phreaknik/MSP432-RGB-LED-Panel-Controller/(threads)

Thread 12 (2015-12-04):

[DOCUMENTATION] - Update firmware license

phreaknik, 2015-12-04:
Perhaps migrate to MIT license, but make sure there are no copyright issues with TI software

phreaknik, 2015-12-04:
Looks like I might have to use TI's license. Read the license in one of the source files, and it says this.

phreaknik, 2015-12-04:
Looks like the only two files that have the TI license are:
 - msp432_startup_ccs.c
 - msp432p401r.cmd
 - (Verify there are no other TI licensed files)

If this is the case, I may not have to use the TI license if I can get the project to work without these files.

msp432_startup_ccs.c - This file holds the interrupt vector table. If I create my own functions within DisplayDriverLib to register interrupts without using this file, then I may not need this file at all.

msp432p401r.cmd - This file may be unnecessary altogether. It looks like it gets auto-generated by CCS, and therefore I dont need to include it with the source code

Thread 5 (2015-12-04):

Hardware - Move voltage regulator away from DC jack.

phreaknik, 2015-12-04:
The clearance between the voltage regulator and the DC jack is too close for comfort when a heatsink is mounted on the regulator.
