phreaknik/MSP432-RGB-LED-Panel-Controller/Hardware/board.pdf

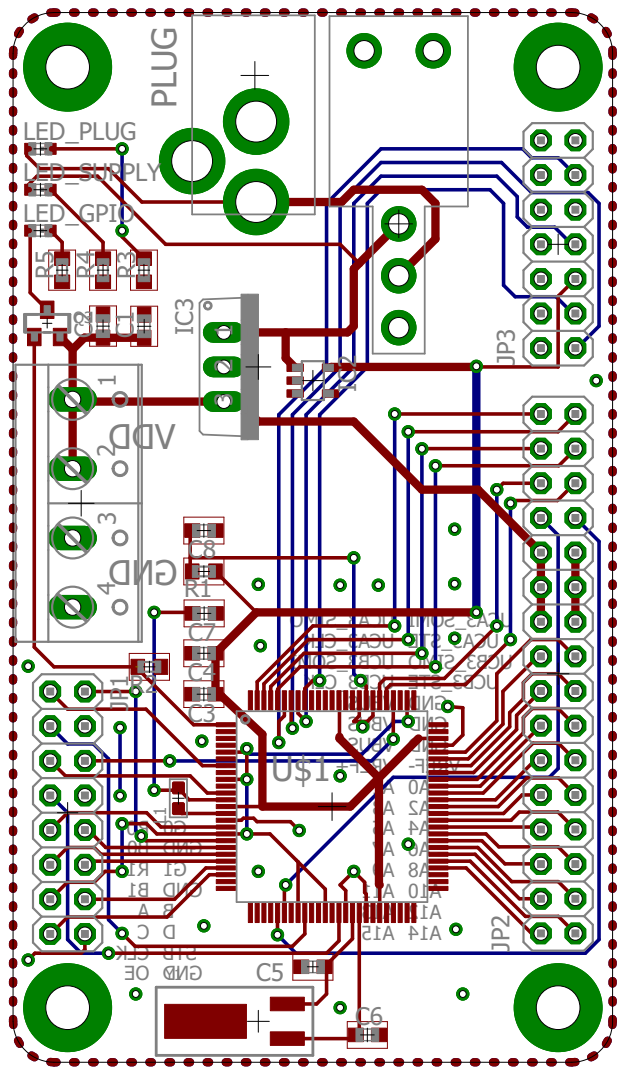
[picture p1: page 1]
