phreaknik/MSP432-RGB-LED-Panel-Controller/Hardware/schematic.pdf

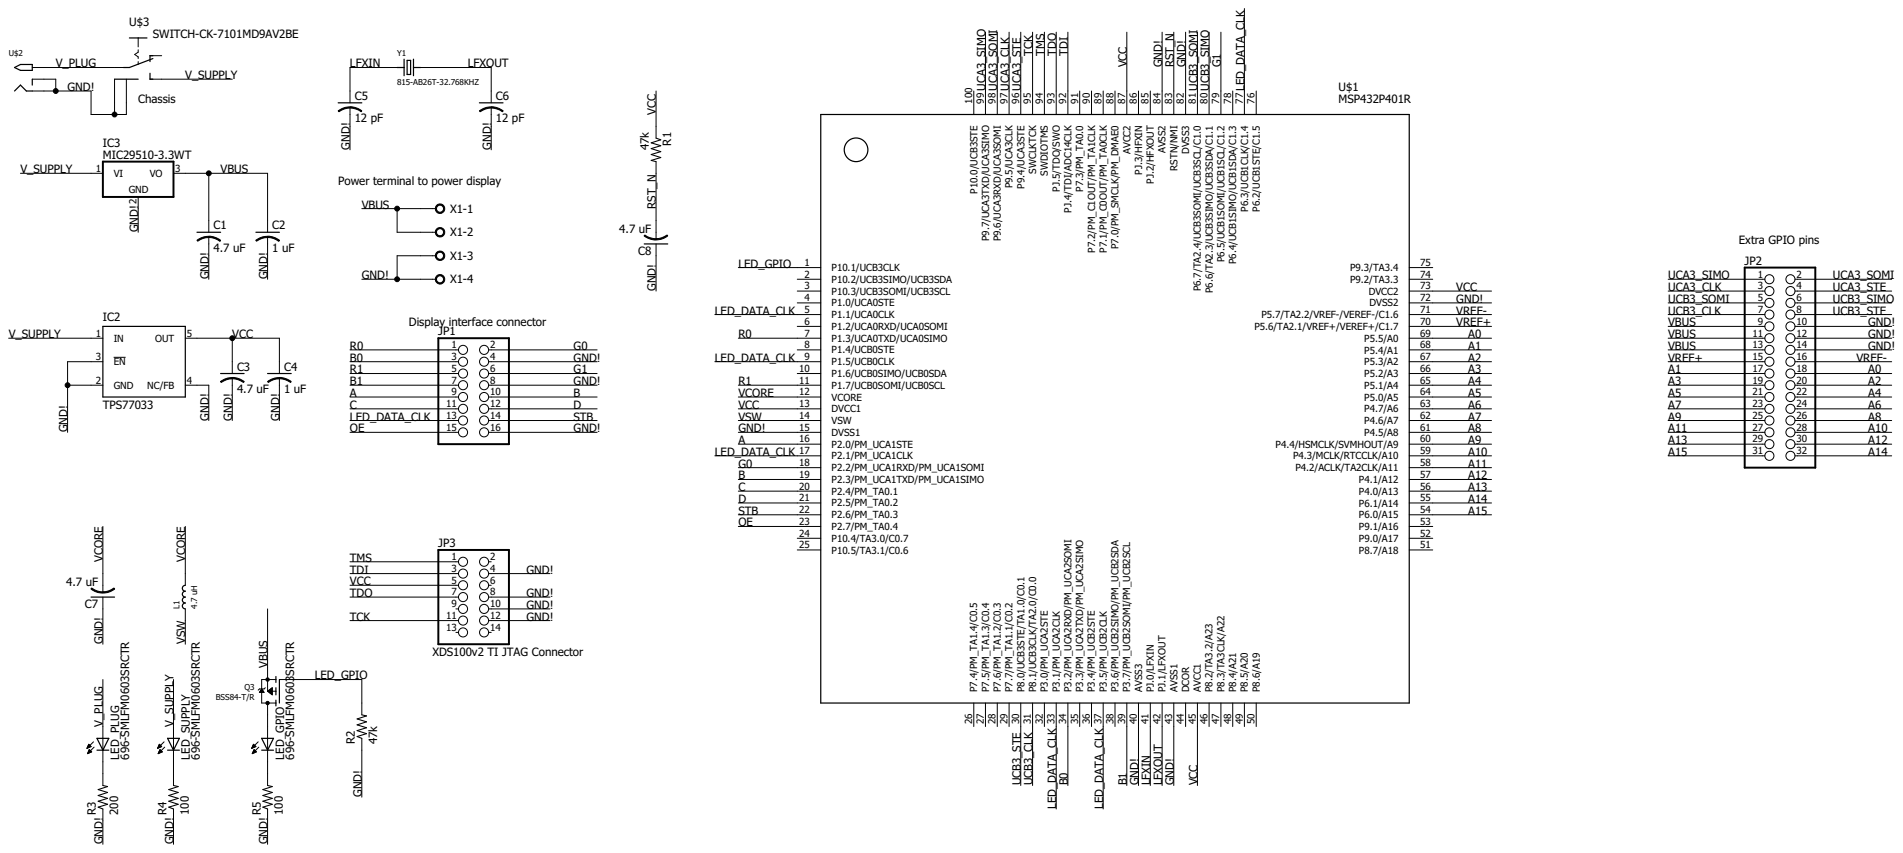
[picture p2: page 1]
