phreaknik/MSP432-RGB-LED-Panel-Controller/Hardware/EagleCAD/RGBDisplayDriver.brd

## EAGLE design Hardware/EagleCAD/RGBDisplayDriver.brd (2015-12-03)

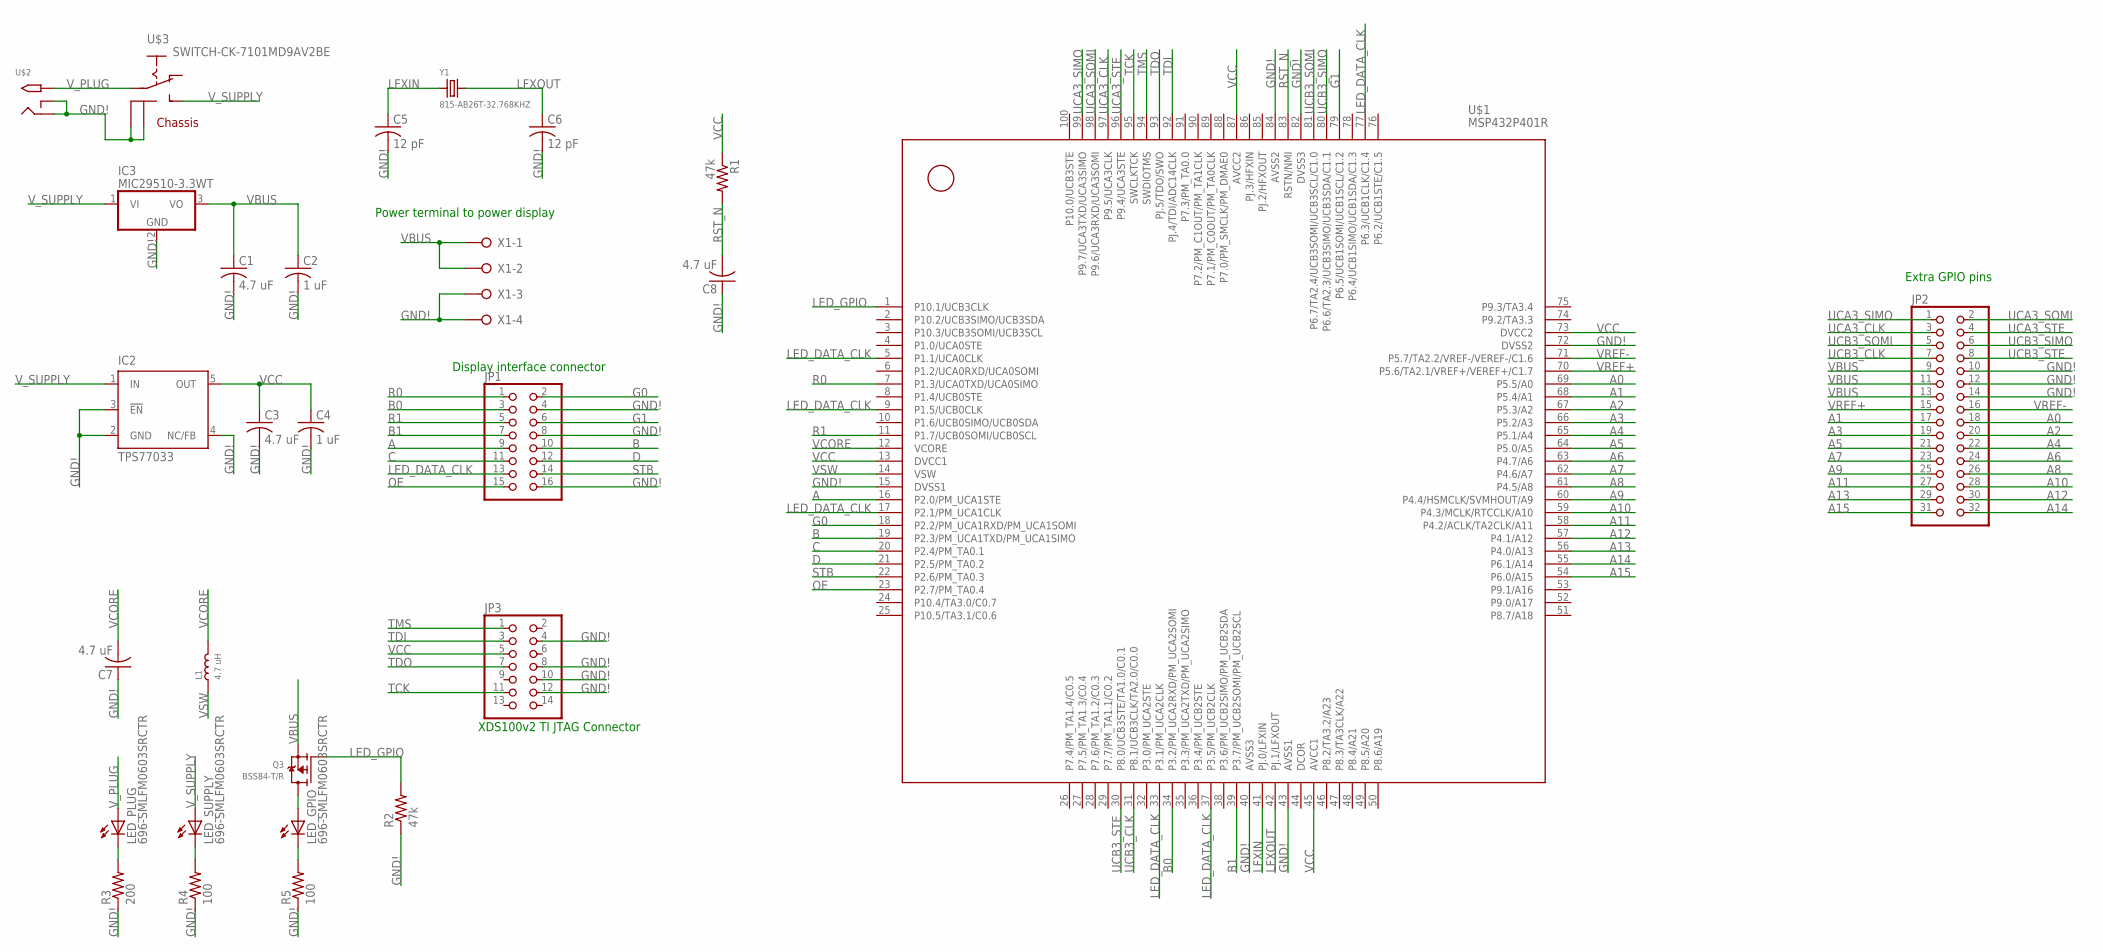
[picture p3: schematic RGBDisplayDriver.sch]

Parts:
C1, C3, C7, C8: 4.7 uF; C0603
C2, C4: 1 uF; C0603
C5, C6: 12 pF; C0603
IC2: TPS77033; SOT23-DBV
IC3: MIC29510-3.3WT; TO220V
JP1: PINHD-2X8; 2X08
JP2: PINHD-2X16; 2X16
JP3: PINHD-2X7; 2X07
L1: 4.7 uH; L0603
LED_GPIO: 696-SMLFM0603SRCTR; CHIPLED_0603
LED_PLUG: 696-SMLFM0603SRCTR; CHIPLED_0603
LED_SUPPLY: 696-SMLFM0603SRCTR; CHIPLED_0603
Q3: BSS84-T/R; SOT23-WIDE
R1, R2: 47k; R0603
R3: 200; R0603
R4, R5: 100; R0603
U$1: MSP432P401R; LQFP100
U$2: 2.1MMJACKTHM; PJ-102A
U$3: SWITCH-CK-7101MD9AV2BE
X1: W237-04P; W237-4P
Y1: 815-AB26T-32.768KHZ; CRYSTAL_CYL_2X6MM_SMT

Connections:
A: JP1.9, U$1.16 (P2.0/PM_UCA1STE)
A0: JP2.18, U$1.69 (P5.5/A0)
A1: JP2.17, U$1.68 (P5.4/A1)
A2: JP2.20, U$1.67 (P5.3/A2)
A3: JP2.19, U$1.66 (P5.2/A3)
A4: JP2.22, U$1.65 (P5.1/A4)
A5: JP2.21, U$1.64 (P5.0/A5)
A6: JP2.24, U$1.63 (P4.7/A6)
A7: JP2.23, U$1.62 (P4.6/A7)
A8: JP2.26, U$1.61 (P4.5/A8)
A9: JP2.25, U$1.60 (P4.4/HSMCLK/SVMHOUT/A9)
A10: JP2.28, U$1.59 (P4.3/MCLK/RTCCLK/A10)
A11: JP2.27, U$1.58 (P4.2/ACLK/TA2CLK/A11)
A12: JP2.30, U$1.57 (P4.1/A12)
A13: JP2.29, U$1.56 (P4.0/A13)
A14: JP2.32, U$1.55 (P6.1/A14)
A15: JP2.31, U$1.54 (P6.0/A15)
B: JP1.10, U$1.19 (P2.3/PM_UCA1TXD/PM_UCA1SIMO)
B0: JP1.3, U$1.34 (P3.2/PM_UCA2RXD/PM_UCA2SOMI)
B1: JP1.7, U$1.39 (P3.7/PM_UCB2SOMI/PM_UCB2SCL)
C: JP1.11, U$1.20 (P2.4/PM_TA0.1)
D: JP1.12, U$1.21 (P2.5/PM_TA0.2)
G0: JP1.2, U$1.18 (P2.2/PM_UCA1RXD/PM_UCA1SOMI)
G1: JP1.6, U$1.79 (P6.5/UCB1SOMI/UCB1SCL/C1.2)
GND!: C1.2, C2.2, C3.2, C4.2, C5.2, C6.2, C7.1, C8.1, IC2.2 (GND), IC2.3 (!EN), IC2.4 (NC/FB), IC3.2 (GND), JP1.4, JP1.8, JP1.16, JP2.10, JP2.12, JP2.14, JP3.4, JP3.8, JP3.10, JP3.12, R2.1, R3.1, R4.1, R5.1, U$1.15 (DVSS1), U$1.40 (AVSS3), U$1.43 (AVSS1), U$1.72 (DVSS2), U$1.82 (DVSS3), U$1.84 (AVSS2), U$2.RING, U$2.RING_SW, U$3.P$4, U$3.P$5, X1.3, X1.4
LED_DATA_CLK: JP1.13, U$1.5 (P1.1/UCA0CLK), U$1.9 (P1.5/UCB0CLK), U$1.17 (P2.1/PM_UCA1CLK), U$1.33 (P3.1/PM_UCA2CLK), U$1.37 (P3.5/PM_UCB2CLK), U$1.77 (P6.3/UCB1CLK/C1.4)
LED_GPIO: Q3.1 (G), R2.2, U$1.1 (P10.1/UCB3CLK)
LFXIN: C5.1, U$1.41 (PJ.0/LFXIN), Y1.1
LFXOUT: C6.1, U$1.42 (PJ.1/LFXOUT), Y1.2
unnamed: LED_GPIO.A, Q3.3 (D)
unnamed: LED_PLUG.C, R3.2
unnamed: LED_SUPPLY.C, R4.2
unnamed: LED_GPIO.C, R5.2
OE: JP1.15, U$1.23 (P2.7/PM_TA0.4)
R0: JP1.1, U$1.7 (P1.3/UCA0TXD/UCA0SIMO)
R1: JP1.5, U$1.11 (P1.7/UCB0SOMI/UCB0SCL)
RST_N: C8.2, R1.2, U$1.83 (RSTN/NMI)
STB: JP1.14, U$1.22 (P2.6/PM_TA0.3)
TCK: JP3.11, U$1.95 (SWCLKTCK)
TDI: JP3.3, U$1.92 (PJ.4/TDI/ADC14CLK)
TDO: JP3.7, U$1.93 (PJ.5/TDO/SWO)
TMS: JP3.1, U$1.94 (SWDIOTMS)
UCA3_CLK: JP2.3, U$1.97 (P9.5/UCA3CLK)
UCA3_SIMO: JP2.1, U$1.99 (P9.7/UCA3TXD/UCA3SIMO)
UCA3_SOMI: JP2.2, U$1.98 (P9.6/UCA3RXD/UCA3SOMI)
UCA3_STE: JP2.4, U$1.96 (P9.4/UCA3STE)
UCB3_CLK: JP2.7, U$1.31 (P8.1/UCB3CLK/TA2.0/C0.0)
UCB3_SIMO: JP2.6, U$1.80 (P6.6/TA2.3/UCB3SIMO/UCB3SDA/C1.1)
UCB3_SOMI: JP2.5, U$1.81 (P6.7/TA2.4/UCB3SOMI/UCB3SCL/C1.0)
UCB3_STE: JP2.8, U$1.30 (P8.0/UCB3STE/TA1.0/C0.1)
VBUS: C1.1, C2.1, IC3.3 (VO), JP2.9, JP2.11, JP2.13, Q3.2 (S), X1.1, X1.2
VCC: C3.1, C4.1, IC2.5 (OUT), JP3.5, R1.1, U$1.13 (DVCC1), U$1.45 (AVCC1), U$1.73 (DVCC2), U$1.87 (AVCC2)
VCORE: C7.2, L1.2, U$1.12 (VCORE)
VREF+: JP2.15, U$1.70 (P5.6/TA2.1/VREF+/VEREF+/C1.7)
VREF-: JP2.16, U$1.71 (P5.7/TA2.2/VREF-/VEREF-/C1.6)
VSW: L1.1, U$1.14 (VSW)
V_PLUG: LED_PLUG.A, U$2.TIP, U$3.P$2
V_SUPPLY: IC2.1 (IN), IC3.1 (VI), LED_SUPPLY.A, U$3.P$1

Notes on the sheet:
Power terminal to power display
Display interface connector
Extra GPIO pins
XDS100v2 TI JTAG Connector

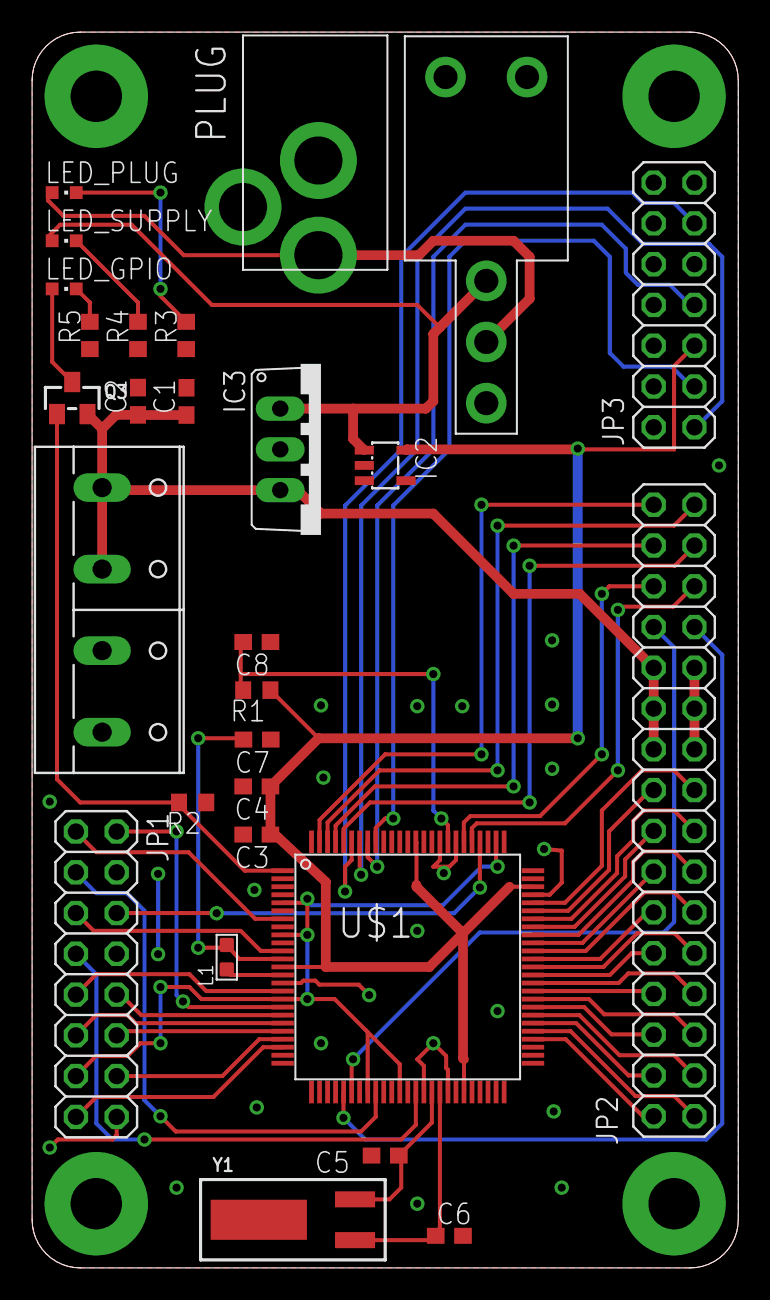
[picture p4: board RGBDisplayDriver.brd from above]

Board: 2 copper layers, 44.0 x 77.0 mm, 28 parts (0 on the bottom side), 58 nets.
