phreaknik/MSP432-RGB-LED-Panel-Controller/Firmware/CCSv6_workspace/DisplayDriver/RGB-LED-Panel-Library/char_map.h

/*
 * char_map.h
 *
 *  Created on: Dec 3, 2015
 *      Author: John
 */

#ifndef CHAR_MAP_H_
#define CHAR_MAP_H_


// Define ASCII character map
const uint32_t charMap[128][7] = {
								{	// Blank
									0b00000,
									0b00000,
									0b00000,
									0b00000,
									0b00000,
									0b00000
								},

								{	// Blank
									0b00000,
									0b00000,
									0b00000,
									0b00000,
									0b00000,
									0b00000
								},

								{	// Blank
									0b00000,
									0b00000,
									0b00000,
									0b00000,
									0b00000,
									0b00000
								},

								{	// Blank
									0b00000,
									0b00000,
									0b00000,
									0b00000,
									0b00000,
									0b00000
								},

								{	// Blank
									0b00000,
									0b00000,
									0b00000,
									0b00000,
									0b00000,
									0b00000
								},

								{	// Blank
									0b00000,
									0b00000,
									0b00000,
									0b00000,
									0b00000,
									0b00000
								},

								{	// Blank
									0b00000,
									0b00000,
									0b00000,
									0b00000,
									0b00000,
									0b00000
								},

								{	// Blank
									0b00000,
									0b00000,
									0b00000,
									0b00000,
									0b00000,
									0b00000
								},

								{	// Blank
									0b00000,
									0b00000,
									0b00000,
									0b00000,
									0b00000,
									0b00000
								},

								{	// Blank
									0b00000,
									0b00000,
									0b00000,
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
									0b00010,
									0b00100,
									0b00100,
									0b01000
								},

								{	// '~'
									0b00000,
									0b00000,
									0b01000,
									0b10101,
									0b00010,
									0b00000,
									0b00000
								}
								};

#endif /* RGB_LED_PANEL_LIBRARY_CHAR_MAP_H_ */
