phreaknik/MSP432-RGB-LED-Panel-Controller/Firmware/CCSv6_workspace/DisplayDriver/msp432_startup_ccs.c

//*****************************************************************************
//
// Copyright (C) 2012 - 2014 Texas Instruments Incorporated - http://www.ti.com/
//
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
//  Redistributions of source code must retain the above copyright 
//  notice, this list of conditions and the following disclaimer.
//
//  Redistributions in binary form must reproduce the above copyright
//  notice, this list of conditions and the following disclaimer in the 
//  documentation and/or other materials provided with the   
//  distribution.
//
//  Neither the name of Texas Instruments Incorporated nor the names of
//  its contributors may be used to endorse or promote products derived
//  from this software without specific prior written permission.
//
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
// MSP432 Family Interrupt Vector Table for CGT
//
//****************************************************************************

/* Forward declaration of the default fault handlers. */
static void resetISR(void);
static void nmiISR(void);
static void faultISR(void);
static void intDefaultHandler(void);


/* External declaration for the reset handler that is to be called when the */
/* processor is started                                                     */
extern void _c_int00(void);


/* Linker variable that marks the top of the stack. */
extern unsigned long __STACK_END;
/* External declarations for the interrupt handlers used by the application. */
extern void DISP__eUSCIA0ISR(void);
extern void DISP__oneShotFlashTimerISR(void);
extern void DISP__frameTimerISR(void);

/* To be added by user */


/* Intrrupt vector table.  Note that the proper constructs must be placed on this to  */
/* ensure that it ends up at physical address 0x0000.0000 or at the start of          */
/* the program if located at a start address other than 0.                            */
#pragma DATA_SECTION(interruptVectors, ".intvecs")
void (* const interruptVectors[])(void) =
{
    (void (*)(void))((unsigned long)&__STACK_END),
                                            /* The initial stack pointer */
    resetISR,                               /* The reset handler         */
    nmiISR,                                 /* The NMI handler           */
    faultISR,                               /* The hard fault handler    */
    intDefaultHandler,                      /* The MPU fault handler     */
    intDefaultHandler,                      /* The bus fault handler     */
    intDefaultHandler,                      /* The usage fault handler   */
    0,                                      /* Reserved                  */
    0,                                      /* Reserved                  */
    0,                                      /* Reserved                  */
    0,                                      /* Reserved                  */
    intDefaultHandler,                      /* SVCall handler            */
    intDefaultHandler,                      /* Debug monitor handler     */
    0,                                      /* Reserved                  */
    intDefaultHandler,                      /* The PendSV handler        */
    intDefaultHandler,                      /* The SysTick handler       */
    intDefaultHandler,                      /* PSS ISR                   */
    intDefaultHandler,                      /* CS ISR                    */
    intDefaultHandler,                      /* PCM ISR                   */
    intDefaultHandler,                      /* WDT ISR                   */
    intDefaultHandler,                      /* FPU ISR                   */
    intDefaultHandler,                      /* FLCTL ISR                 */
    intDefaultHandler,                      /* COMP0 ISR                 */
    intDefaultHandler,                      /* COMP1 ISR                 */
	DISP__oneShotFlashTimerISR,  	              	/* TA0_0 ISR                 */
    intDefaultHandler,                      /* TA0_N ISR                 */
	DISP__frameTimerISR, 		                    /* TA1_0 ISR                 */
    intDefaultHandler,                      /* TA1_N ISR                 */
    intDefaultHandler,                      /* TA2_0 ISR                 */
    intDefaultHandler,                      /* TA2_N ISR                 */
    intDefaultHandler,                      /* TA3_0 ISR                 */
    intDefaultHandler,                      /* TA3_N ISR                 */
	DISP__eUSCIA0ISR,                      /* EUSCIA0 ISR               */
	intDefaultHandler,                      /* EUSCIA1 ISR               */
	intDefaultHandler,                      /* EUSCIA2 ISR               */
    intDefaultHandler,                      /* EUSCIA3 ISR               */
	intDefaultHandler,                      /* EUSCIB0 ISR               */
	intDefaultHandler,                      /* EUSCIB1 ISR               */
	intDefaultHandler,                      /* EUSCIB2 ISR               */
    intDefaultHandler,                      /* EUSCIB3 ISR               */
    intDefaultHandler,                    	/* ADC14 ISR                 */
    intDefaultHandler,                      /* T32_INT1 ISR              */
    intDefaultHandler,                      /* T32_INT2 ISR              */
    intDefaultHandler,                      /* T32_INTC ISR              */
    intDefaultHandler,                      /* AES ISR                   */
    intDefaultHandler,                      /* RTC ISR                   */
    intDefaultHandler,                      /* DMA_ERR ISR               */
    intDefaultHandler,                      /* DMA_INT3 ISR              */
    intDefaultHandler,                      /* DMA_INT2 ISR              */
    intDefaultHandler,                      /* DMA_INT1 ISR              */
    intDefaultHandler,                      /* DMA_INT0 ISR              */
    intDefaultHandler,                        /* PORT1 ISR                 */
    intDefaultHandler,                      /* PORT2 ISR                 */
    intDefaultHandler,                      /* PORT3 ISR                 */
    intDefaultHandler,                      /* PORT4 ISR                 */
    intDefaultHandler,                      /* PORT5 ISR                 */
    intDefaultHandler,                      /* PORT6 ISR                 */
    intDefaultHandler,                      /* Reserved 41               */
    intDefaultHandler,                      /* Reserved 42               */
    intDefaultHandler,                      /* Reserved 43               */
    intDefaultHandler,                      /* Reserved 44               */
    intDefaultHandler,                      /* Reserved 45               */
    intDefaultHandler,                      /* Reserved 46               */
    intDefaultHandler,                      /* Reserved 47               */
    intDefaultHandler,                      /* Reserved 48               */
    intDefaultHandler,                      /* Reserved 49               */
    intDefaultHandler,                      /* Reserved 50               */
    intDefaultHandler,                      /* Reserved 51               */
    intDefaultHandler,                      /* Reserved 52               */
    intDefaultHandler,                      /* Reserved 53               */
    intDefaultHandler,                      /* Reserved 54               */
    intDefaultHandler,                      /* Reserved 55               */
    intDefaultHandler,                      /* Reserved 56               */
    intDefaultHandler,                      /* Reserved 57               */
    intDefaultHandler,                      /* Reserved 58               */
    intDefaultHandler,                      /* Reserved 59               */
    intDefaultHandler,                      /* Reserved 60               */
    intDefaultHandler,                      /* Reserved 61               */
    intDefaultHandler,                      /* Reserved 62               */
    intDefaultHandler,                      /* Reserved 63               */
    intDefaultHandler                       /* Reserved 64               */
};


/* This is the code that gets called when the processor first starts execution */
/* following a reset event.  Only the absolutely necessary set is performed,   */
/* after which the application supplied entry() routine is called.  Any fancy  */
/* actions (such as making decisions based on the reset cause register, and    */
/* resetting the bits in that register) are left solely in the hands of the    */
/* application.                                                                */
void resetISR(void)
{
    /* Jump to the CCS C Initialization Routine. */
    __asm("    .global _c_int00\n"
          "    b.w     _c_int00");
}


/* This is the code that gets called when the processor receives a NMI.  This  */
/* simply enters an infinite loop, preserving the system state for examination */
/* by a debugger.                                                              */
static void nmiISR(void)
{
    /* Enter an infinite loop. */
    while(1)
    {
    }
}


/* This is the code that gets called when the processor receives a fault        */
/* interrupt.  This simply enters an infinite loop, preserving the system state */
/* for examination by a debugger.                                               */
static void faultISR(void)
{
    /* Enter an infinite loop. */
    while(1)
    {
    }
}


/* This is the code that gets called when the processor receives an unexpected  */
/* interrupt.  This simply enters an infinite loop, preserving the system state */
/* for examination by a debugger.                                               */
static void intDefaultHandler(void)
{
    /* Enter an infinite loop. */
    while(1)
    {
    }
}
