phreaknik/MSP432-RGB-LED-Panel-Controller/Firmware/CCSv6_workspace/DisplayDriver-Test-HardCodedText/main.c

#include "msp.h"
#include <stdint.h>
#include "Drivers/RGB_Matrix_16x32.h"

// Main
//**********************************
int main(void) {
	// Initialize MCU
    WDTCTL = WDTPW | WDTHOLD;               // Stop WDT

    CSKEY = 0x695A;                        	// Unlock CS module for register access
    CSCTL0 = 0;                            	// Reset tuning parameters
    CSCTL0 = DCORSEL_5;           			// Set DCO to 48MHz nominal
    /* Select MCLK = DCO, no divider */
    CSCTL1 = CSCTL1 & ~(SELM_M | DIVM_M) | SELM_3;
    CSKEY = 0;                             	// Lock CS module from unintended accesses

    // Initialize display driver
    initDisplayDriver();						// Configure pins to drive display
    displayRGB16x32 display;				// Create instance of the display

    // Just initialize the array to something for now
    display.redRow[0] = 	0b00000000000000000000000000000000;
    display.redRow[1] = 	0b00000000000000000000000000000000;
    display.redRow[2] = 	0b00000000000000000000000000000000;
    display.redRow[3] = 	0b00000000000000000000000000000000;
    display.redRow[4] = 	0b00000000000000000000000000000000;
    display.redRow[5] = 	0b00000000000000000000000000000000;
    display.redRow[6] = 	0b00000000000000000000000000000000;
    display.redRow[7] = 	0b00000000000000000000000000000000;
    display.redRow[8] = 	0b00000000000000000000000000000000;
    display.redRow[9] = 	0b00000000000000000000000000000000;
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
    display.blueRow[13] = 	0b00000111111111111111111111100000;
    display.blueRow[14] = 	0b00000000000000000000000000000000;
    display.blueRow[15] = 	0b00000000000000000000000000000000;

    while(1)
    {
    	refreshDisplay(&display);

    	delayCycles((uint32_t) 0);
    }
}
