phreaknik/MSP432-RGB-LED-Panel-Controller/(commit log)

2015-12-03 Fixing up CCS workspace
    [main.c, msp432_startup_ccs.c]
2015-12-03 Added test firmwares
    -DisplayDriver-Test-BlinkLED: Blinks the LED to verify the PCB
    -DisplayDriver-Test-HardCodedText: Displays hardcoded text to test the
    display
2015-12-03 Added hardware design files
    [RGBDisplayDriver.brd, RGBDisplayDriver.sch]
2015-12-03 Added PDF schematic
2015-12-03 Renamed Hardware\RGBDisplayDriver to Hardware\EagleCAD
    [RGBDisplayDriver.brd, RGBDisplayDriver.sch]
2015-12-04 Fixed bug and cleaned up code
    - Added limits to the color values in setColorPDM()
    - Removed #define DISP__COLOR_BITS because it is unused
    [main.c]
2015-12-04 Adding RGB-LED-Panel-Library as submodule
2015-12-04 Revert "Adding RGB-LED-Panel-Library as submodule"
    This reverts commit b664f91dc61b45637774f31538c26f3a898435c4.
2015-12-04 Fixed bug with drawRect() drawing off-screen (GitHub issue #6)
    [RGB_LED_Panel.c, RGB_LED_Panel.h, main.c]
2015-12-23 Added include option for driverLib
2016-01-02 Fixed drawLine() so that it can draw steep lines
    [RGB_LED_Panel.c, main.c]
2016-01-02 Fixed drawRect() to only draw outline
    [RGB_LED_Panel.c]
2016-01-02 Fixed drawCircle() to only draw outline
    [RGB_LED_Panel.c, main.c]
2016-01-03 fixed drawChar() so that it can handle strings
    [RGB_LED_Panel.c, RGB_LED_Panel.h, char_map.h, main.c]
